TheBeaninator/ir-kvm/(commit log)

2026-09-29 ir-kvm: IR-driven out-of-band KVM (HDMI switch + addressed IR USB keyboards)
    - hdmi-switch: NEC codes for the 5:1 HDMI switch via the Tiqiaa Tview USB IR dongle
    - irkbd.py + irkbd-firmware: IRKB addressed IR bus, XIAO ESP32S3 as USB HID keyboard,
    fast bit timing + 16-char string frames (~70 chars/s), CRC-8, seq dedup
    - kvm wrapper, irprobe.py code-discovery helper, udev rule, installer
    - tiqiaa_usb_ir.py driver by Norman Rasmussen (see NOTICE)
2026-09-29 RP2040 port + IR-LED transmitter nodes; irtx transmitter abstraction
    - irkbd-firmware builds for XIAO RP2040 (TinyUSB raw HID reports, EEPROM node id)
    and XIAO ESP32S3 from one sketch
    - RP2040 nodes transmit through an IR LED on D9 (38 kHz PWM carrier): serial
    commands irkb/nec/raw/ping; id 255 = blaster-only node that never types
    - irtx.py: one interface over the Tiqiaa dongle and serial nodes, auto-detected
    (IRKVM_TX overrides); irkbd/hdmi-switch/irsend/irprobe use it
    - README: RP2040 recommended (no radio), LED wiring, build/flash for both boards
2026-09-29 screen.py: the V — grab frames from the HDMI capture stick, or serve the latest frame from /dev/shm
    MS2109 on USB 2: 1080p10 and 720p30 are clean, higher modes overrun the bus; the stick
    emits blank frames for ~2 s after streaming starts, so cold grabs skip them.
2026-09-29 README: HDMI switch hot-plug gotcha and fixes (EDID emulators, video=...e, amdgpu trigger_hotplug)
2026-09-29 kvm: re-trigger hot-plug on this machine's own connector after selecting itself (IRKVM_SELF)
2026-10-01 Power node: ESP32S3 Wi-Fi node drives the Matter strip on IR frame type 4; irpower.py
